newdexterity/Coaxial-Benchmarking-Platform/BOM.xlsx

Product | # | Link
LOAD CELL AMP HX711 | 4 | https://www.digikey.co.nz/product-detail/en/sparkfun-electronics/SEN-13879/1568-1436-ND/6202732
KR SENSE CURRENT/VOLTAGE 45A BRD | 2 | https://www.digikey.co.nz/product-detail/en/sparkfun-electronics/SEN-16407/1568-SEN-16407-ND/11685948
5 kg beam load cell | 4 | https://www.digikey.co.nz/product-detail/en/adafruit-industries-llc/4541/1528-4541-ND/12323573
Light-based speed sensor | 2 | https://www.digikey.co.nz/product-detail/en/american-bright-optoelectronics-corporation/BPR-301/BPR-301-ND/9678549
National Instruments MyRIO | 3 | https://www.ni.com/en-nz/shop/hardware/products/myrio-student-embedded-device.html
40x40 mm aluminium extrusion [m] | 10 | https://autoline.nz/products/aluminium-t-slot-extrusion/4-series/40-x-40-slotpro-4-slot-standard-extrusion/
30x30 mm aluminium extrusion [m] | 10 | https://autoline.nz/products/aluminium-t-slot-extrusion/3-series/30-x-30-slotpro-4-slot-standard-extrusion/
