newdexterity/Coaxial-Benchmarking-Platform/CAD/Small_thrust_torque_rig - axis.STL

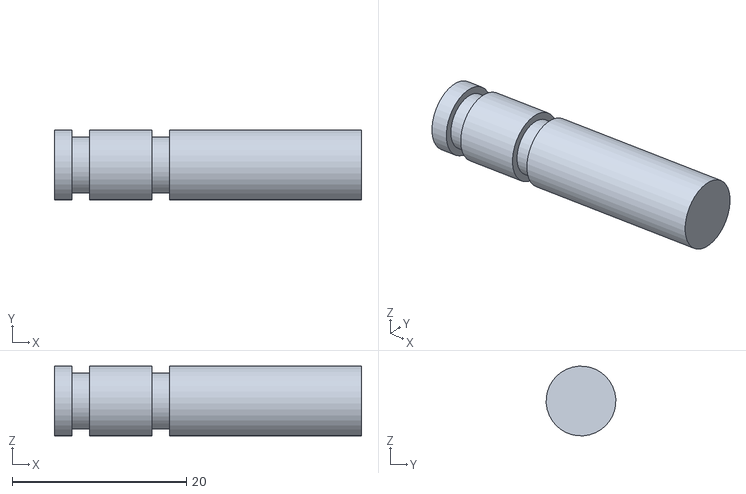
[picture p1: CAD file, 2022-04-05]
CAD/Small_thrust_torque_rig - axis.STL
35.2 x 7.98 x 7.98
