newdexterity/Coaxial-Benchmarking-Platform/CAD/Small_thrust_torque_rig - 5kg_load_cell.STL

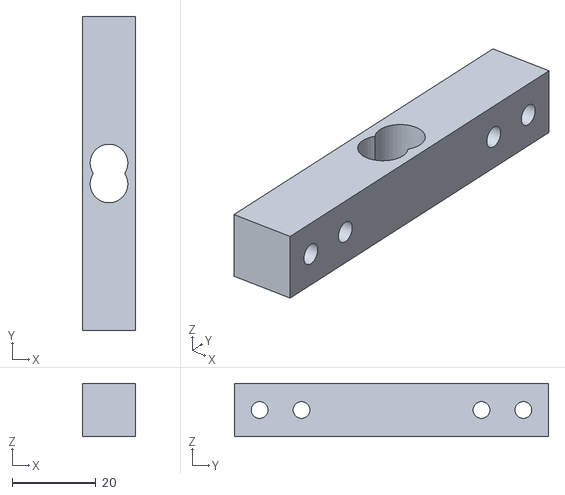
[picture p2: CAD file, 2022-04-05]
CAD/Small_thrust_torque_rig - 5kg_load_cell.STL
12.7 x 75.0 x 12.7
