newdexterity/Coaxial-Benchmarking-Platform/CAD/Small_thrust_torque_rig - thrust_cell2stand.STL

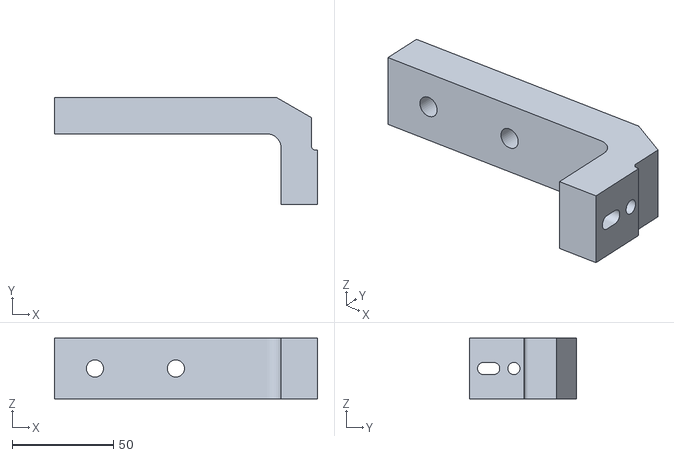
[picture p3: CAD file, 2022-04-05]
CAD/Small_thrust_torque_rig - thrust_cell2stand.STL
130.0 x 53.0 x 30.0
