newdexterity/Coaxial-Benchmarking-Platform/CAD/Small_thrust_torque_rig - load_cells_mount_rotor_left.STL

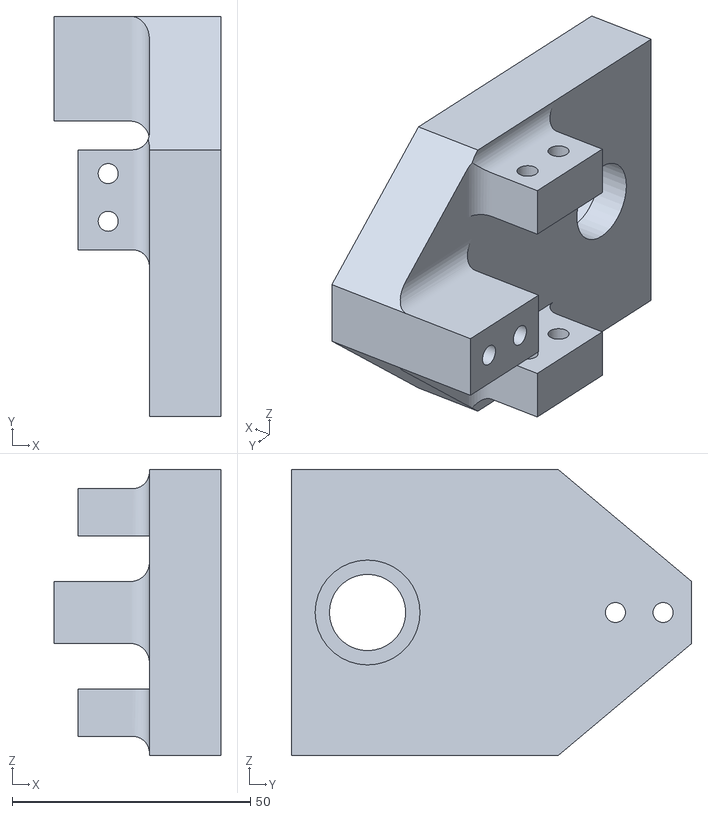
[picture p4: CAD file, 2022-04-05]
CAD/Small_thrust_torque_rig - load_cells_mount_rotor_left.STL
35.0 x 84.0 x 60.0
