newdexterity/Coaxial-Benchmarking-Platform/CAD/Small_thrust_torque_rig.STEP

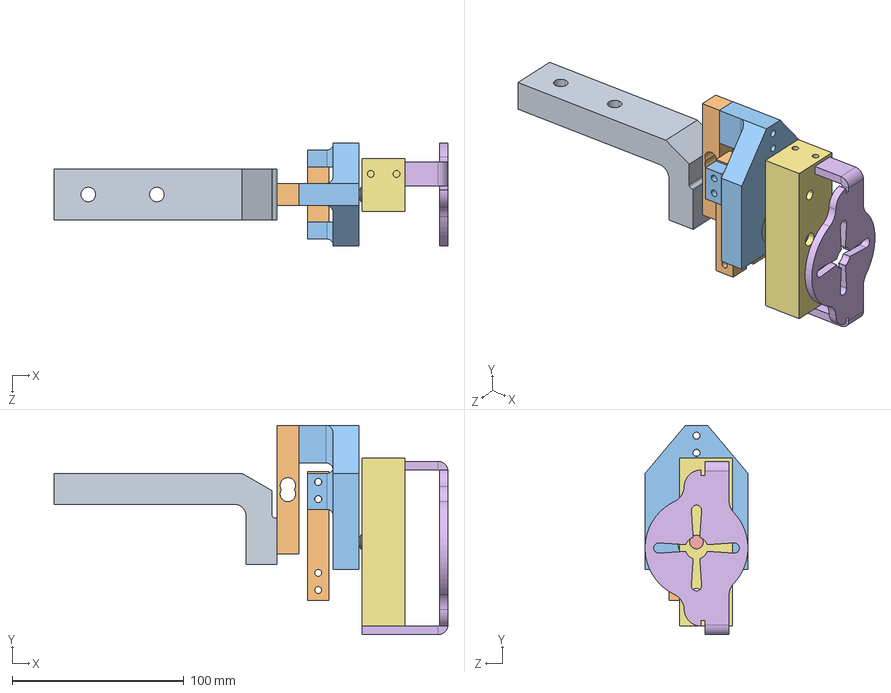
[picture p5: CAD file, 2022-04-05]
CAD/Small_thrust_torque_rig.STEP
229.7 x 122.0 x 60.0 mm
thrust_cell2stand
5kg_load_cell x 3
load_cells_mount_rotor_left
bearing
axis
motor_mount_small_rig_plate
mouting_plate2axis
