newdexterity/Coaxial-Benchmarking-Platform/CAD/Small_thrust_torque_rig - mouting_plate2axis.STL

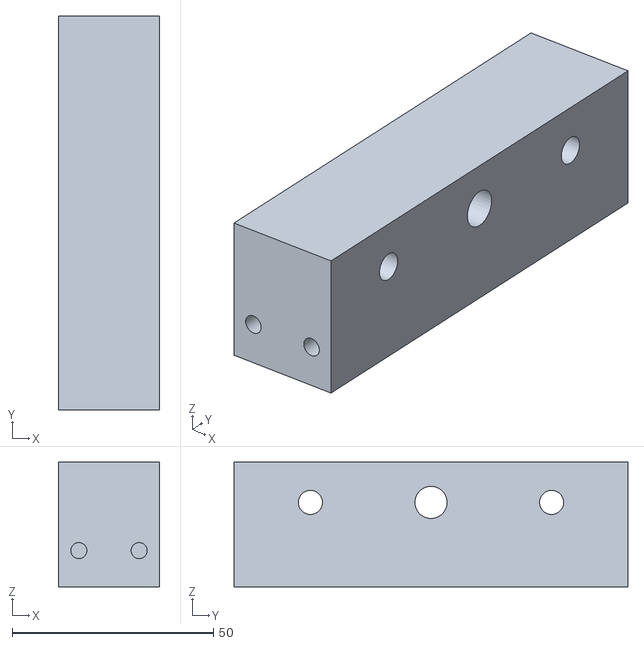
[picture p6: CAD file, 2022-04-05]
CAD/Small_thrust_torque_rig - mouting_plate2axis.STL
25.0 x 98.0 x 31.0
