newdexterity/Coaxial-Benchmarking-Platform/CAD/Small_thrust_torque_rig - motor_mount_small_rig_plate.STL

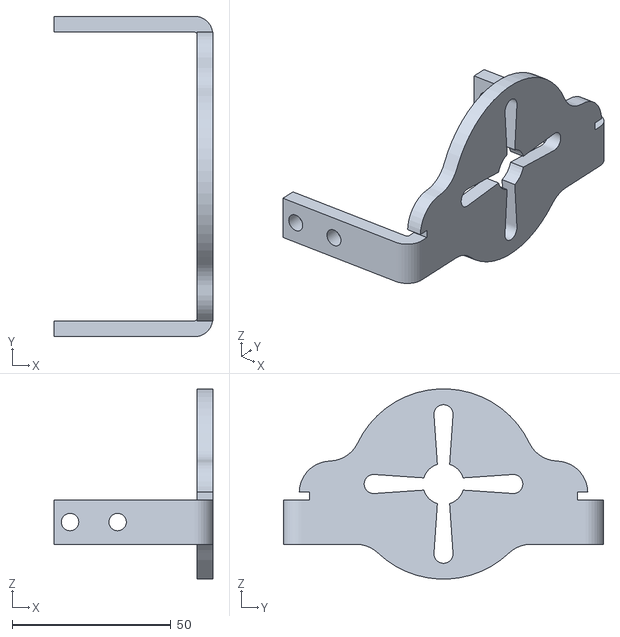
[picture p7: CAD file, 2022-04-05]
CAD/Small_thrust_torque_rig - motor_mount_small_rig_plate.STL
50.0 x 101.0 x 59.9
