newdexterity/Coaxial-Benchmarking-Platform/CAD/Small_thrust_torque_rig - bearing.STL

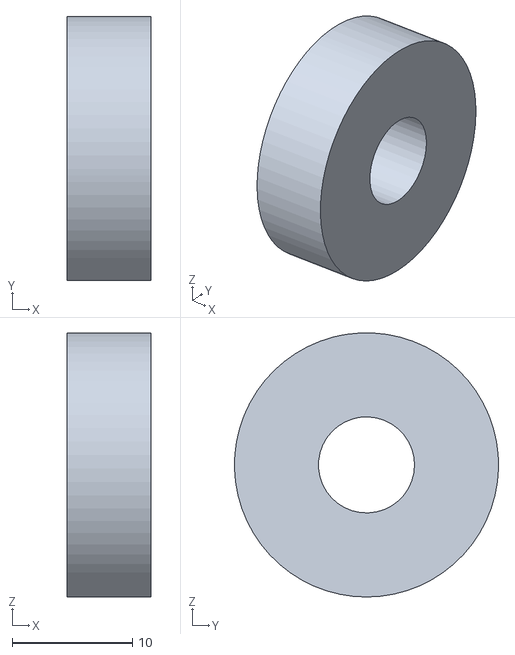
[picture p8: CAD file, 2022-04-05]
CAD/Small_thrust_torque_rig - bearing.STL
7.00 x 22.0 x 22.0
