newdexterity/Coaxial-Benchmarking-Platform/(commit log)

2021-09-12 Added CAD files
    [5kg_load_cell.SLDPRT, Small_thrust_torque_rig.SLDASM, axis.SLDPRT, bearing.SLDPRT, electronics_box.SLDPRT, light_mount.SLDASM, light_mount_root.SLDPRT, light_mount_slide1.SLDPRT]
2021-09-12 Added BOM
    [BOM.xlsx]
2021-10-24 Added more complete BOM
    [Coaxial Benchmarking Platform - BOM.xlsx]
2022-08-20 Files for the workshop at CASE 2022
